leshy/go2_lidar_cage_cage/go2-lidar-cage.step

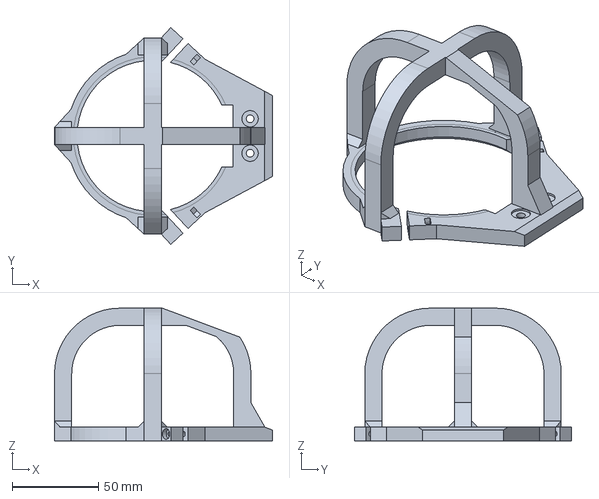
[picture p7: CAD file, 2026-10-25]
go2-lidar-cage.step
126.5 x 125.8 x 77.0 mm
