leshy/go2_lidar_cage_cage/ref/head_shell_8000.stl

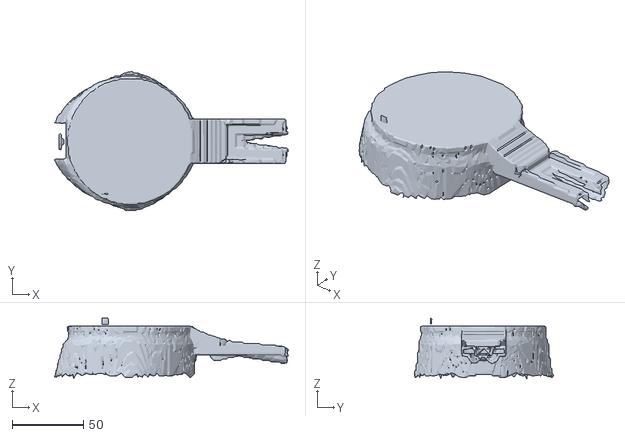
[picture p8: CAD file, 2026-10-25]
ref/head_shell_8000.stl
163.7 x 97.1 x 42.6
