leshy/go2_lidar_cage_cage/(list of files, cad)

Other CAD files:
go2-lidar-cage.stl
