leshy/go2_lidar_cage_cage/(commit log)

2026-10-25 Go2 L1 lidar outer cage: model, print STL/STEP, bump FEA, floor check
    [go2-lidar-cage.step, go2-lidar-cage.stl, head_shell_8000.stl]
2026-10-25 README: drop frame/measurements section
2026-10-25 pytest: fit asserts, floor clearance, STL up to date; CI on push
